michalbagrowski/comms-joystick/(commit log)

2026-01-17 working servo
2026-01-27 add battery
2026-01-28 fix bom git
2026-01-29 add 3d
    [rx_car_chassis.scad, tx_controller.scad]
